johnludeke/acoustic-stimulation-to-improve-sleep/README.md

# Acoustic Stimulation to Improve Sleep

This repo will contain all code and notebooks related to our senior design project.
