johnludeke/acoustic-stimulation-to-improve-sleep/schematics/SCHEMATICS.md

# Schematics are located in this folder.
