johnludeke/acoustic-stimulation-to-improve-sleep/schematics/audio_and_power/audio_and_power.kicad_pcb

## KiCad design schematics/audio_and_power/audio_and_power.kicad_pcb (2026-04-07)

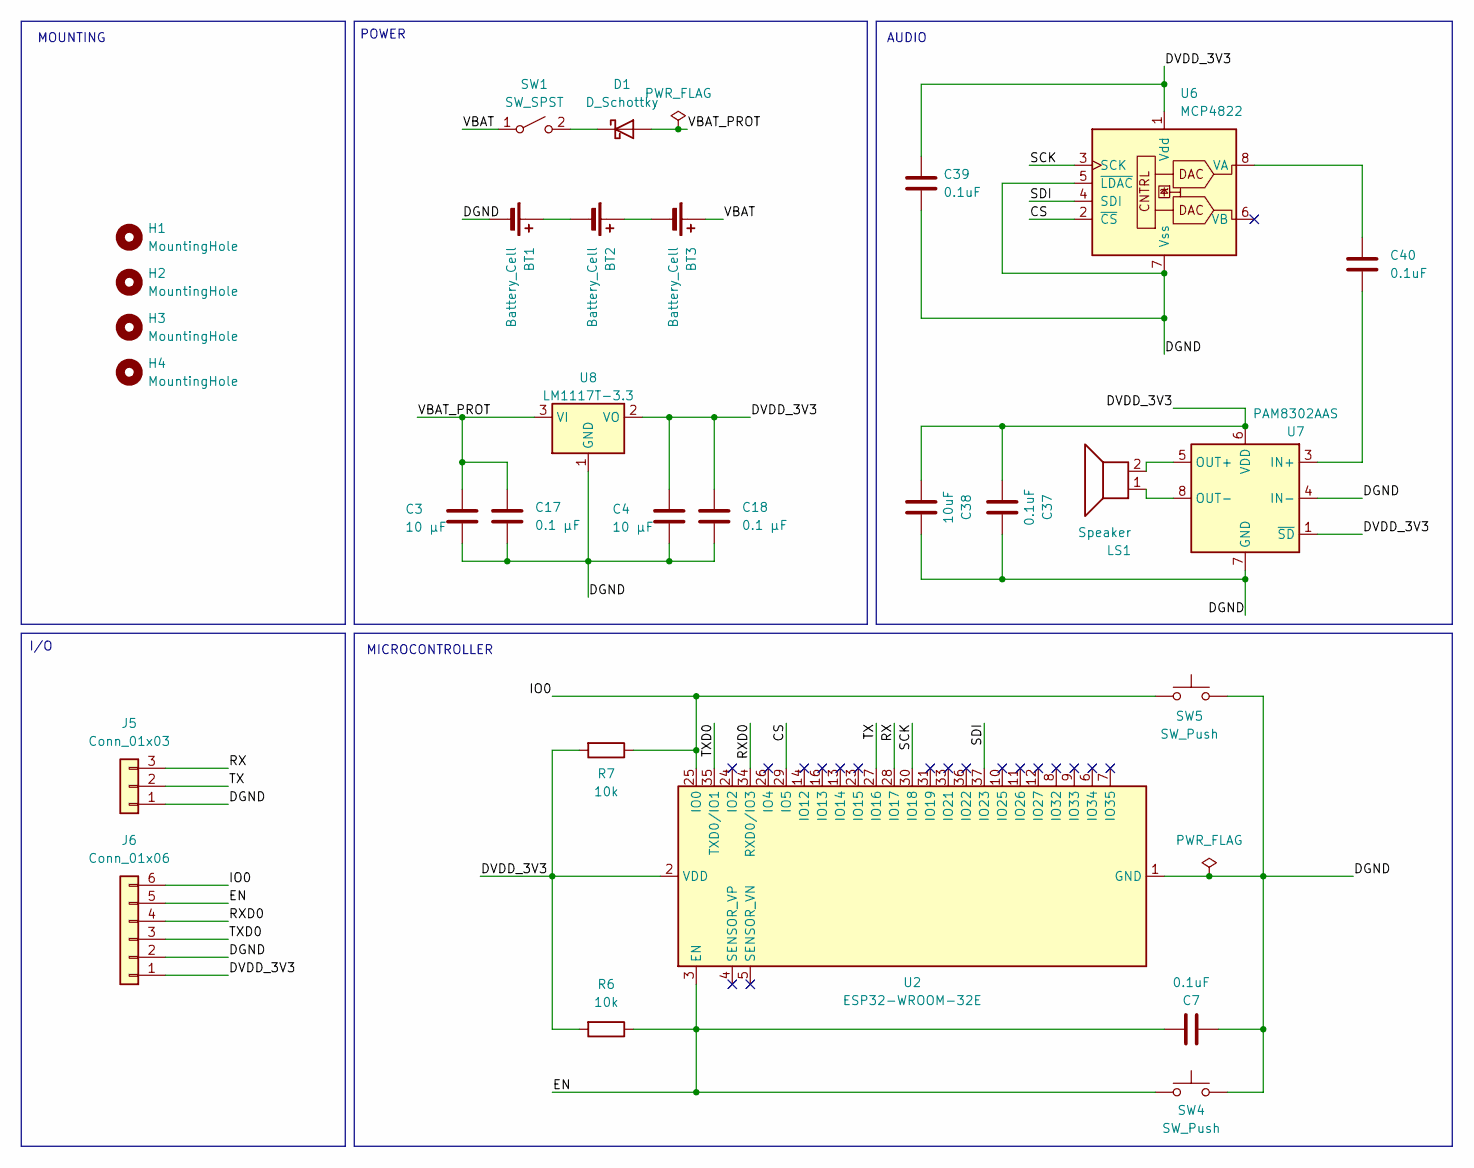
[picture p1: schematic audio_and_power.kicad_sch]

Parts:
BT1, BT2, BT3: Battery_Cell; PinHeader_1x02_P2.54mm_Vertical
C3, C4: 10 µF; C_0603_1608Metric
C7, C37, C39, C40: 0.1uF; C_0603_1608Metric
C17, C18: 0.1 µF; C_0603_1608Metric
C38: 10uF; C_0805_2012Metric
D1: D_Schottky; D_SOD-123
H1, H2, H3, H4: MountingHole; MountingHole_3.2mm_M3
J5: Conn_01x03; PinHeader_1x03_P2.54mm_Vertical
J6: Conn_01x06; PinHeader_1x06_P2.54mm_Vertical
LS1: Speaker; PinHeader_1x02_P2.54mm_Vertical
R6, R7: 10k; R_0603_1608Metric
SW1: SW_SPST; SW_DIP_SPSTx01_Slide_6.7x4.1mm_W8.61mm_P2.54mm_LowProfile
SW4, SW5: SW_Push; SW_SPST_TL3342
U2: ESP32-WROOM-32E; ESP32-WROOM-32D
U6: MCP4822; MSOP-8_3x3mm_P0.65mm
U7: PAM8302AAS; MSOP-8_3x3mm_P0.65mm
U8: LM1117T-3.3; TO-220-3_Horizontal_TabDown

Connections:
/CS: U2.29 (IO5), U6.2 (~CS)
/DGND: BT1.2 (-), C3.2, C4.2, C7.1, C17.2, C18.2, C37.2, C38.2, C39.2, J5.1, J6.2, SW4.2, SW5.2, U2.1 (GND), U2.15 (GND), U2.38 (GND), U2.39 (GND), U6.5 (~LDAC), U6.7 (Vss), U7.4 (IN-), U7.7 (GND), U8.1 (GND)
/DVDD_3V3: C4.1, C18.1, C37.1, C38.1, C39.1, J6.1, R6.2, R7.2, U2.2 (VDD), U6.1 (Vdd), U7.1 (~SD), U7.6 (VDD), U8.2 (VO)
/EN: C7.2, J6.5, R6.1, SW4.1, U2.3 (EN)
/IO0: J6.6, R7.1, SW5.1, U2.25 (IO0)
/RX: J5.3, U2.28 (IO17)
/RXD0: J6.4, U2.34 (RXD0/IO3)
/SCK: U2.30 (IO18), U6.3 (SCK)
/SDI: U2.37 (IO23), U6.4 (SDI)
/TX: J5.2, U2.27 (IO16)
/TXD0: J6.3, U2.35 (TXD0/IO1)
/VBAT: BT3.1 (+), SW1.1 (A)
/VBAT_PROT: C3.1, C17.1, D1.2 (A), U8.3 (VI)
unnamed: BT1.1 (+), BT2.2 (-)
unnamed: BT2.1 (+), BT3.2 (-)
unnamed: D1.1 (K), SW1.2 (B)
unnamed: C40.1, U6.8 (VA)
unnamed: C40.2, U7.3 (IN+)
unnamed: LS1.2, U7.5 (OUT+)
unnamed: LS1.1, U7.8 (OUT-)

Notes on the sheet:
I/O
MOUNTING
AUDIO
MICROCONTROLLER
POWER

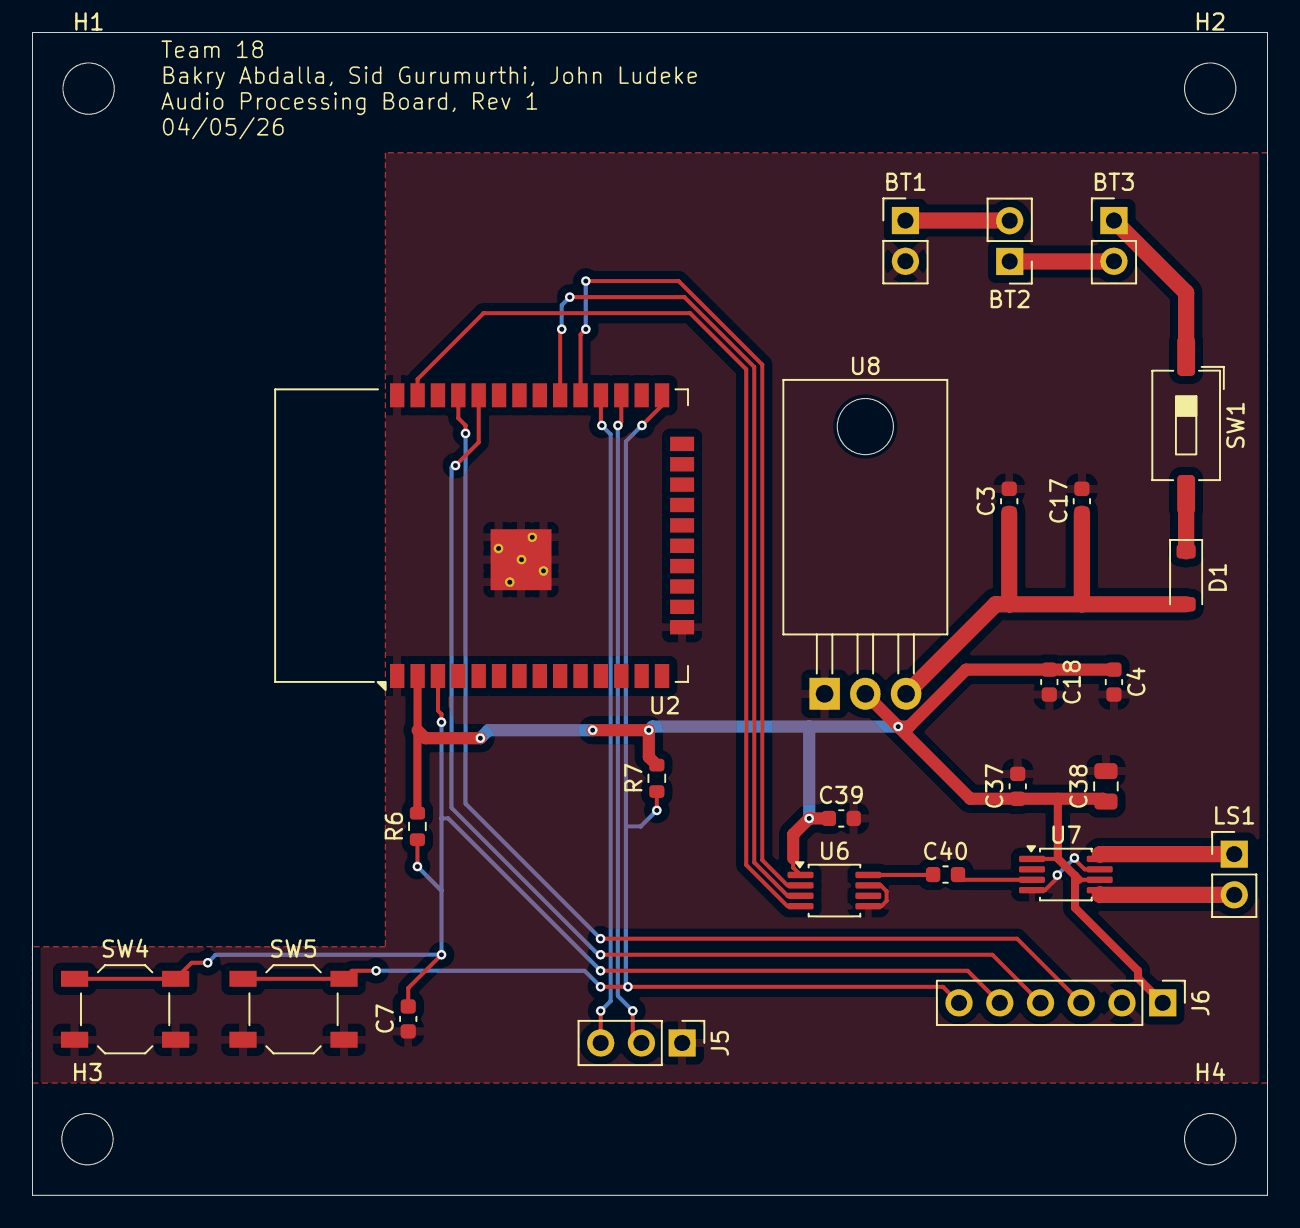
[picture p2: board audio_and_power.kicad_pcb from above]

Board: 2 copper layers, 77.0 x 72.5 mm, 29 parts (0 on the bottom side), 20 nets.
