johnludeke/acoustic-stimulation-to-improve-sleep/schematics/playground1/playground.kicad_pcb

## KiCad design schematics/playground1/playground.kicad_pcb (2026-03-31)

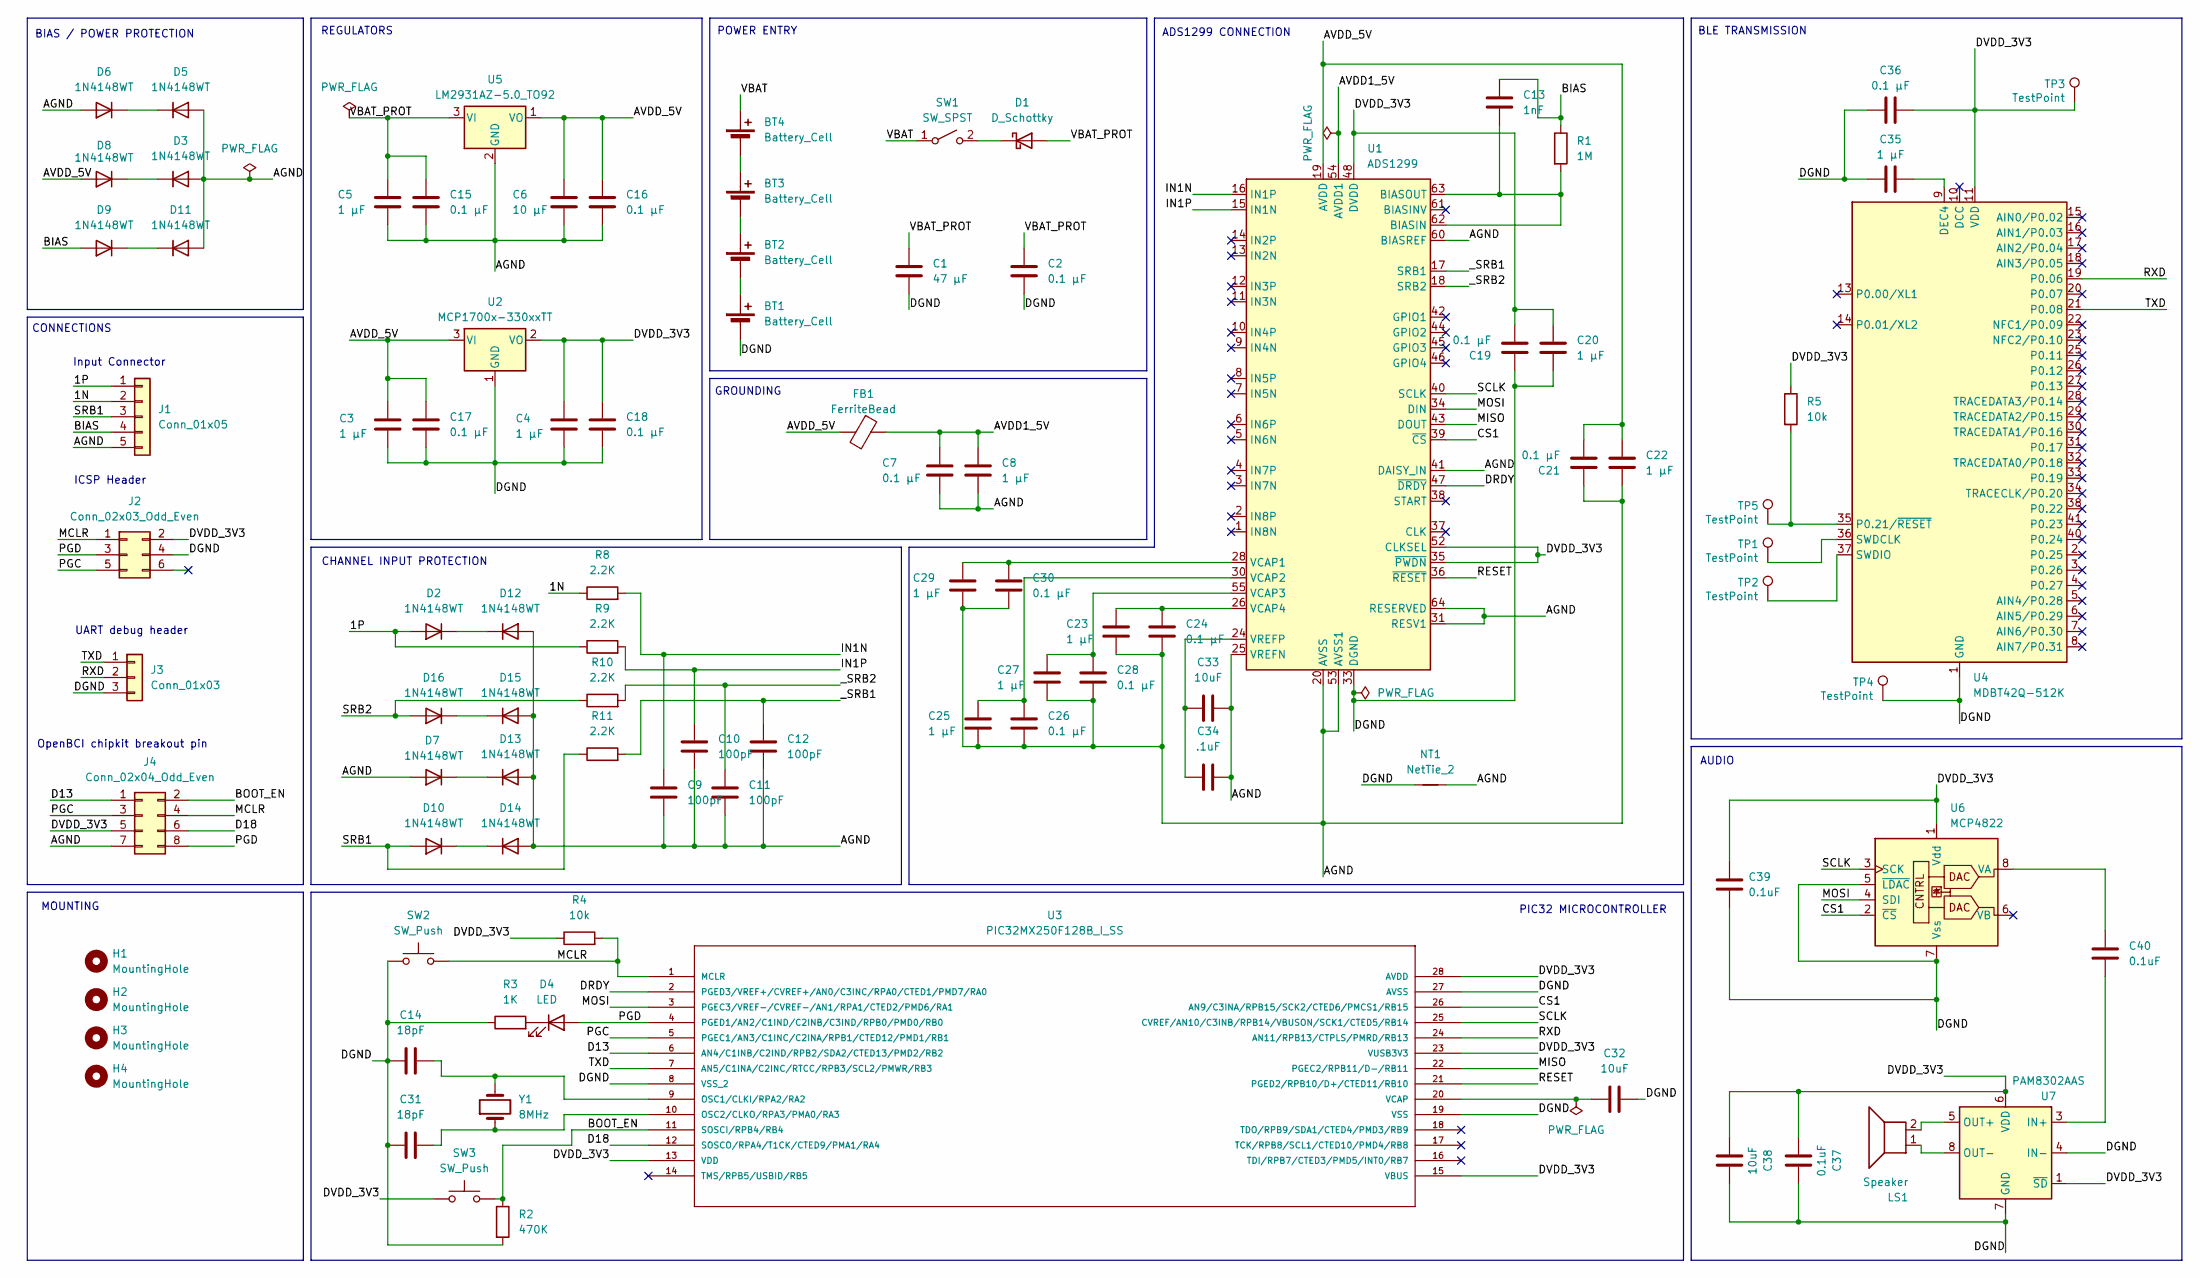
[picture p3: schematic playground.kicad_sch]

Parts:
BT1, BT2, BT3, BT4: Battery_Cell; PinHeader_1x02_P2.54mm_Vertical
C1: 47 µF; CP_Radial_D6.3mm_P2.50mm
C2, C7, C15, C16, C17, C18, C19, C21, C24, C26, C28, C30, C36: 0.1 µF; C_0603_1608Metric
C3, C4, C5, C8, C20, C22, C23, C25, C27, C29, C35: 1 µF; C_0603_1608Metric
C6: 10 µF; C_0805_2012Metric
C9, C10, C11, C12: 100pF; C_0603_1608Metric
C13: 1nF; C_0603_1608Metric
C14, C31: 18pF; C_0603_1608Metric
C32, C33, C38: 10uF; C_0805_2012Metric
C34: .1uF; C_0603_1608Metric
C37, C39, C40: 0.1uF; C_0603_1608Metric
D1: D_Schottky; D_SOD-123
D2, D3, D5, D6, D7, D8, D9, D10, D11, D12, D13, D14, D15, D16: 1N4148WT; D_SOD-523
D4: LED; LED_0603_1608Metric_Pad1.05x0.95mm_HandSolder
FB1: FerriteBead; L_0603_1608Metric
H1, H2, H3, H4: MountingHole; MountingHole_3.2mm_M3
J1: Conn_01x05; PinHeader_1x05_P2.54mm_Vertical
J2: Conn_02x03_Odd_Even; PinHeader_2x03_P2.54mm_Vertical
J3: Conn_01x03; PinHeader_1x03_P2.54mm_Vertical
J4: Conn_02x04_Odd_Even; PinHeader_2x04_P2.54mm_Vertical
LS1: Speaker; PinHeader_1x02_P2.54mm_Vertical
NT1: NetTie_2; NetTie-2_SMD_Pad0.5mm
R1: 1M; R_0603_1608Metric
R2: 470K; R_0603_1608Metric
R3: 1K; R_0603_1608Metric
R4, R5: 10k; R_0603_1608Metric
R8, R9, R10, R11: 2.2K; R_0603_1608Metric
SW1: SW_SPST; SW_DIP_SPSTx01_Slide_6.7x4.1mm_W8.61mm_P2.54mm_LowProfile
SW2, SW3: SW_Push; SW_SPST_EVQP0
TP1, TP2, TP3, TP4, TP5: TestPoint; TestPoint_Pad_D1.0mm
U1: ADS1299; TQFP-64_10x10mm_P0.5mm
U2: MCP1700x-330xxTT; SOT-23
U3: PIC32MX250F128B_I_SS; SSOP-28_5.3x10.2mm_P0.65mm
U4: MDBT42Q-512K; Raytac_MDBT42Q
U5: LM2931AZ-5.0_TO92; TO-92_Inline
U6: MCP4822; MSOP-8_3x3mm_P0.65mm
U7: PAM8302AAS; MSOP-8_3x3mm_P0.65mm
Y1: 8MHz; Crystal_SMD_3225-4Pin_3.2x2.5mm

Connections:
/1N: J1.2, R8.1
/1P: D2.2 (A), J1.1, R9.1
/AGND: C5.2, C6.1, C7.2, C8.2, C9.2, C10.2, C11.2, C12.2, C15.2, C16.2, C21.1, C22.2, C23.2, C24.2, C25.2, C26.2, C27.2, C28.2, C29.2, C30.2, C33.2, C34.1, D3.2 (A), D5.2 (A), D6.2 (A), D7.2 (A), D11.2 (A), D12.2 (A), D13.2 (A), D14.2 (A), D15.2 (A), J1.5, J4.7, NT1.2, U1.20 (AVSS), U1.23 (AVSS), U1.25 (VREFN), U1.31 (RESV1), U1.32 (AVSS), U1.41 (DAISY_IN), U1.53 (AVSS1), U1.57 (AVSS), U1.58 (AVSS), U1.60 (BIASREF), U1.64 (RESERVED), U5.2 (GND)
/AVDD1_5V: C7.1, C8.1, FB1.1, U1.54 (AVDD1)
/AVDD_5V: C3.1, C6.2, C16.1, C17.1, C21.2, C22.1, D8.2 (A), FB1.2, U1.19 (AVDD), U1.21 (AVDD), U1.22 (AVDD), U1.56 (AVDD), U1.59 (AVDD), U2.3 (VI), U5.1 (VO)
/BIAS: C13.1, D9.2 (A), J1.4, R1.1
/BOOT_EN: J4.2, R2.1, SW3.2, U3.11 (SOSCI/RPB4/RB4)
/CS1: U1.39 (~CS), U3.26 (AN9/C3INA/RPB15/SCK2/CTED6/PMCS1/RB15), U6.2 (~CS)
/D13: J4.1, U3.6 (AN4/C1INB/C2IND/RPB2/SDA2/CTED13/PMD2/R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)
/D18: J4.6, U3.12 (SOSCO/RPA4/T1CK/CTED9/PMA1/RA4)
/DGND: BT1.2 (-), C1.2, C2.2, C3.2, C4.2, C14.1, C17.2, C18.2, C19.1, C20.2, C31.2, C32.2, C35.1, C36.1, C37.2, C38.2, C39.2, J2.4, J3.3, NT1.1, R2.2, R3.1, SW2.1, TP4.1, U1.33 (DGND), U1.49 (DGND), U1.51 (DGND), U2.1 (GND), U3.8 (VSS_2), U3.19 (VSS), U3.27 (AVSS), U4.1 (GND), U4.12 (GND), U4.24 (GND), U4.39 (GND), U6.5 (~LDAC), U6.7 (Vss), U7.4 (IN-), U7.7 (GND)
/DRDY: U1.47 (~DRDY), U3.2 (PGED3/VREF+/CVREF+/AN0/C3INC/RPA0/CTED1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)
/DVDD_3V3: C4.1, C18.1, C19.2, C20.1, C36.2, C37.1, C38.1, C39.1, J2.2, J4.5, R4.1, R5.1, SW3.1, TP3.1, U1.35 (~PWDN), U1.48 (DVDD), U1.50 (DVDD), U1.52 (CLKSEL), U2.2 (VO), U3.13 (VDD), U3.15 (VBUS), U3.23 (VUSB3V3), U3.28 (AVDD), U4.11 (VDD), U6.1 (Vdd), U7.1 (~SD), U7.6 (VDD)
/IN1N: C9.1, R8.2, U1.16 (IN1P)
/IN1P: C10.1, R9.2, U1.15 (IN1N)
/MCLR: J2.1, J4.4, R4.2, SW2.2, U3.1 (MCLR)
/MISO: U1.43 (DOUT), U3.22 (PGEC2/RPB11/D-/RB11)
/MOSI: U1.34 (DIN), U3.3 (PGEC3/VREF-/CVREF-/AN1/RPA1/CTED2/PMD6/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), U6.4 (SDI)
/PGC: J2.5, J4.3, U3.5 (PGEC1/AN3/C1INC/C2INA/RPB1/CTED12/PMD1/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)
/PGD: D4.2 (A), J2.3, J4.8, U3.4 (PGED1/AN2/C1IND/C2INB/C3IND/RPB0/PMD0/R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)
/RESET: U1.36 (~RESET), U3.21 (PGED2/RPB10/D+/CTED11/RB10)
/RXD: J3.2, U3.24 (AN11/RPB13/CTPLS/PMRD/RB13), U4.19 (P0.06)
/SCLK: U1.40 (SCLK), U3.25 (CVREF/AN10/C3INB/RPB14/VBUSON/SCK1/CTED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), U6.3 (SCK)
/SRB1: D10.2 (A), J1.3, R11.1
/SRB2: D16.2 (A), R10.1
/TXD: J3.1, U3.7 (AN5/C1INA/C2INC/RTCC/RPB3/SCL2/PMWR/RB3), U4.21 (P0.08)
/VBAT: BT4.1 (+), SW1.1 (A)
/VBAT_PROT: C1.1, C2.1, C5.1, C15.1, D1.2 (A), U5.3 (VI)
/_SRB1: C12.1, R11.2, U1.17 (SRB1)
/_SRB2: C11.1, R10.2, U1.18 (SRB2)
unnamed: BT1.1 (+), BT2.2 (-)
unnamed: BT2.1 (+), BT3.2 (-)
unnamed: BT3.1 (+), BT4.2 (-)
unnamed: D1.1 (K), SW1.2 (B)
unnamed: D3.1 (K), D8.1 (K)
unnamed: D4.1 (K), R3.2
unnamed: D5.1 (K), D6.1 (K)
unnamed: D10.1 (K), D14.1 (K)
unnamed: D9.1 (K), D11.1 (K)
unnamed: D2.1 (K), D12.1 (K)
unnamed: D7.1 (K), D13.1 (K)
unnamed: D15.1 (K), D16.1 (K)
unnamed: C13.2, R1.2, U1.62 (BIASIN), U1.63 (BIASOUT)
unnamed: C29.1, C30.1, U1.28 (VCAP1)
unnamed: C25.1, C26.1, U1.30 (VCAP2)
unnamed: C27.1, C28.1, U1.55 (VCAP3)
unnamed: C23.1, C24.1, U1.26 (VCAP4)
unnamed: C33.1, C34.2, U1.24 (VREFP)
unnamed: C14.2, U3.9 (OSC1/CLKI/RPA2/RA2), Y1.2
unnamed: C31.1, U3.10 (OSC2/CLKO/RPA3/PMA0/RA3), Y1.1
unnamed: C32.1, U3.20 (VCAP)
unnamed: C35.2, U4.9 (DEC4)
unnamed: R5.2, TP5.1, U4.35 (P0.21/~RESET)
unnamed: TP1.1, U4.36 (SWDCLK)
unnamed: TP2.1, U4.37 (SWDIO)
unnamed: C40.1, U6.8 (VA)
unnamed: C40.2, U7.3 (IN+)
unnamed: LS1.2, U7.5 (OUT+)
unnamed: LS1.1, U7.8 (OUT-)

Notes on the sheet:
CHANNEL INPUT PROTECTION
MOUNTING
UART debug header
POWER ENTRY
CONNECTIONS
Input Connector
AUDIO
BIAS / POWER PROTECTION
GROUNDING
ICSP Header
REGULATORS
OpenBCI chipkit breakout pin
PIC32 MICROCONTROLLER
ADS1299 CONNECTION
BLE TRANSMISSION

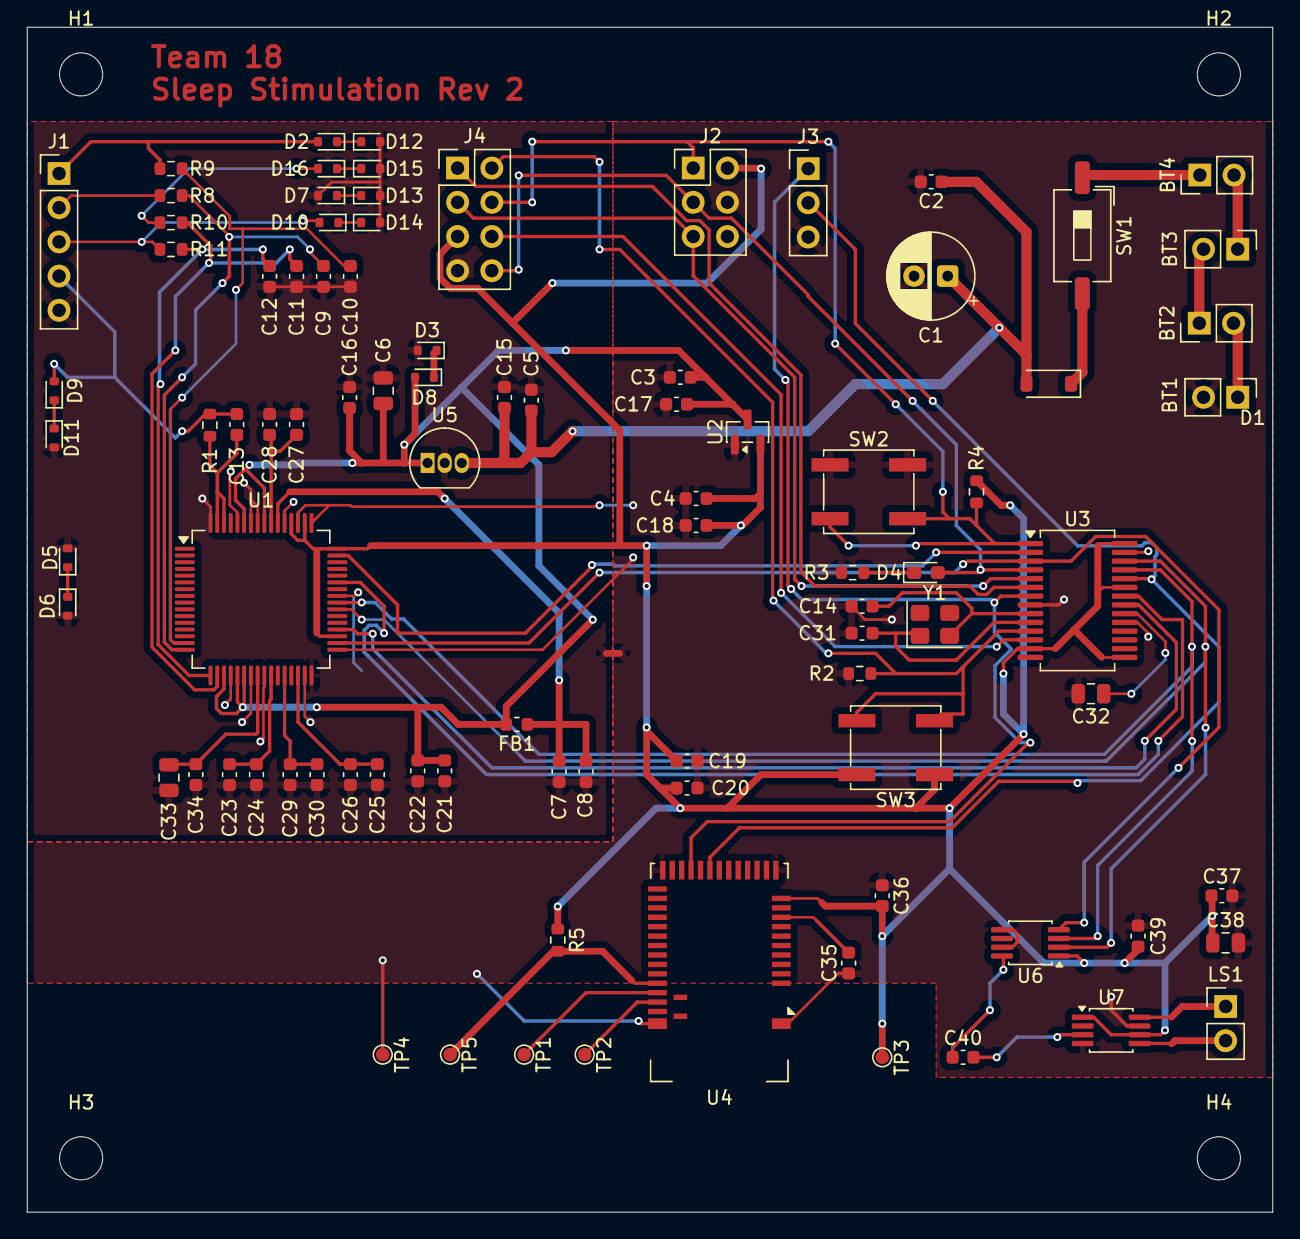
[picture p4: board playground.kicad_pcb from above]

Board: 2 copper layers, 92.5 x 88.0 mm, 96 parts (0 on the bottom side), 59 nets.
