johnludeke/acoustic-stimulation-to-improve-sleep/(commit log)

2026-03-02 IP - work on integrating pic32
    [pic32.kicad_sch, playground.kicad_sch]
2026-03-05 first draft of pic32 schematic complete
    [pic32.kicad_sch]
2026-03-05 channel input protection
    [playground.kicad_sch]
2026-03-05 channel input protection + bias/power protection
    [playground.kicad_sch]
2026-03-05 update voltage regulators to ones we can buy
    [pic32.kicad_sch, playground.kicad_sch]
2026-03-05 consolidate schematics into one file
    [pic32.kicad_sch, playground.kicad_sch]
2026-03-05 fix some errors
    [playground.kicad_sch]
2026-03-06 fixed label not connected ERC errors
    [playground.kicad_sch]
2026-03-06 fixed remaining pin/power errors
    [playground.kicad_sch]
2026-03-10 update w/ footprints
    [playground.kicad_pcb, playground.kicad_sch]
2026-03-11 organize PCB, add AGND and DGND nets, but no wiring
    [playground.kicad_pcb, playground.kicad_sch]
2026-03-12 wiring and generating gerber files
    [playground.kicad_pcb, playground.kicad_sch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]
2026-03-12 change power subsystem to be dgnd, generate gerbers
    [playground.kicad_pcb, playground.kicad_sch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]
2026-03-12 pcb sent
    [playground.kicad_pcb]
2026-03-23 added audio arduino code from breadboard demo
2026-03-23 Update README with recent project developments
    Expanded the README to include recent updates and notes on the design document, signal processing subsystem, and PCB development.
2026-03-23 Revise README with latest project updates
    Updated the README with recent development notes and design decisions regarding the PCB and signal processing subsystem.
2026-03-23 Revise README with PCB routing and design updates
    Updated README with recent PCB development notes and design decisions.
2026-03-23 fixing unconnected items drc errors
    [playground.kicad_pcb]
2026-03-24 AGND connection issues fixed
    [playground.kicad_pcb]
2026-03-25 dgnd connection errors, some fixed
    [playground.kicad_pcb]
2026-03-25 Update README with recent PCB and design notes
    Added recent updates and fixes for dgnd and agnd pin connections. Included detailed notes on PCB design, component selection, and signal processing subsystem development.
2026-03-25 avdd fixes
    [playground.kicad_pcb]
2026-03-26 fixed all errors for pcb with no audio or ble
    [playground.kicad_pcb]
2026-03-26 add bluetooth chip to schematic and pcb
    [playground.kicad_pcb, playground.kicad_sch]
2026-03-26 updated revision number for pcb
    [playground.kicad_pcb]
2026-03-26 audio subsystem added in schematic + footprints
    [playground.kicad_sch]
2026-03-26 clean up audio schematic, wire audio in and move ble
    [playground.kicad_pcb, playground.kicad_sch]
2026-03-26 changed resistor and capacitor combination component to individual capacitors and resistors
    [playground.kicad_sch]
2026-03-26 add tracing for new resistor / diode arrays
    [playground.kicad_pcb, playground.kicad_sch]
2026-03-26 traced pcb audio subsys edits
    [playground.kicad_pcb, playground.kicad_sch]
2026-03-26 ensuring schematic pushed
    [playground.kicad_sch]
2026-03-31 resolve changes
    [playground.kicad_pcb]
2026-04-06 create new audio processor schematic + pcb + gerbers
    [audio_and_power-B_Cu.gbr, audio_and_power-B_Mask.gbr, audio_and_power-B_Paste.gbr, audio_and_power-B_Silkscreen.gbr, audio_and_power-Edge_Cuts.gbr, audio_and_power-F_Cu.gbr, audio_and_power-F_Mask.gbr, audio_and_power-F_Paste.gbr]
2026-04-06 change hole sizes for pcb ordering
    [audio_and_power-B_Cu.gbr, audio_and_power-B_Mask.gbr, audio_and_power-B_Paste.gbr, audio_and_power-B_Silkscreen.gbr, audio_and_power-Edge_Cuts.gbr, audio_and_power-F_Cu.gbr, audio_and_power-F_Mask.gbr, audio_and_power-F_Paste.gbr]
2026-04-06 arduino code to plot eeg channels
2026-04-06 change hole size on esp32
    [audio_and_power.kicad_pcb]
2026-04-06 reformat files. create pink noise generator based off waves
    [plot_eeg_channels.ino, waveform_stim.ino]
2026-04-07 few updates to random things
    [audio_and_power-B_Cu.gbr, audio_and_power-B_Mask.gbr, audio_and_power-B_Paste.gbr, audio_and_power-B_Silkscreen.gbr, audio_and_power-Edge_Cuts.gbr, audio_and_power-F_Cu.gbr, audio_and_power-F_Mask.gbr, audio_and_power-F_Paste.gbr]
2026-04-09 drill files
    [audio_and_power-B_Cu.gbr, audio_and_power-B_Mask.gbr, audio_and_power-B_Paste.gbr, audio_and_power-B_Silkscreen.gbr, audio_and_power-Edge_Cuts.gbr, audio_and_power-F_Cu.gbr, audio_and_power-F_Mask.gbr, audio_and_power-F_Paste.gbr]
2026-04-14 python prototype for feature extraction
2026-04-19 python prototype of linear regression, MLP models for SWS prediction, expanding on feature extraction script
2026-04-24 new code for custom pcb
2026-04-24 updated python script with visuals for: fft of sws epoch, bandpass filtering in time domain to find dominant sws oscillation frequency, using that + trough detection to estimate peaks, peaks are wher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
2026-04-26 code for just playing flat noise
    [play_noise.ino]
2026-04-27 add webapp code and update arduino code to send to webapp instead of python
2026-05-05 Update fmt.Println message from 'Hello' to 'Goodbye'
2026-05-05 Update print statement from 'Hello' to 'Goodbye'
